Kneatrum/Irrigation_controller/documentation/Hardware/v2/PCB Files/IrrigationTimer.kicad_pcb

## KiCad design documentation/Hardware/v2/PCB Files/IrrigationTimer.kicad_pcb (2026-04-17)

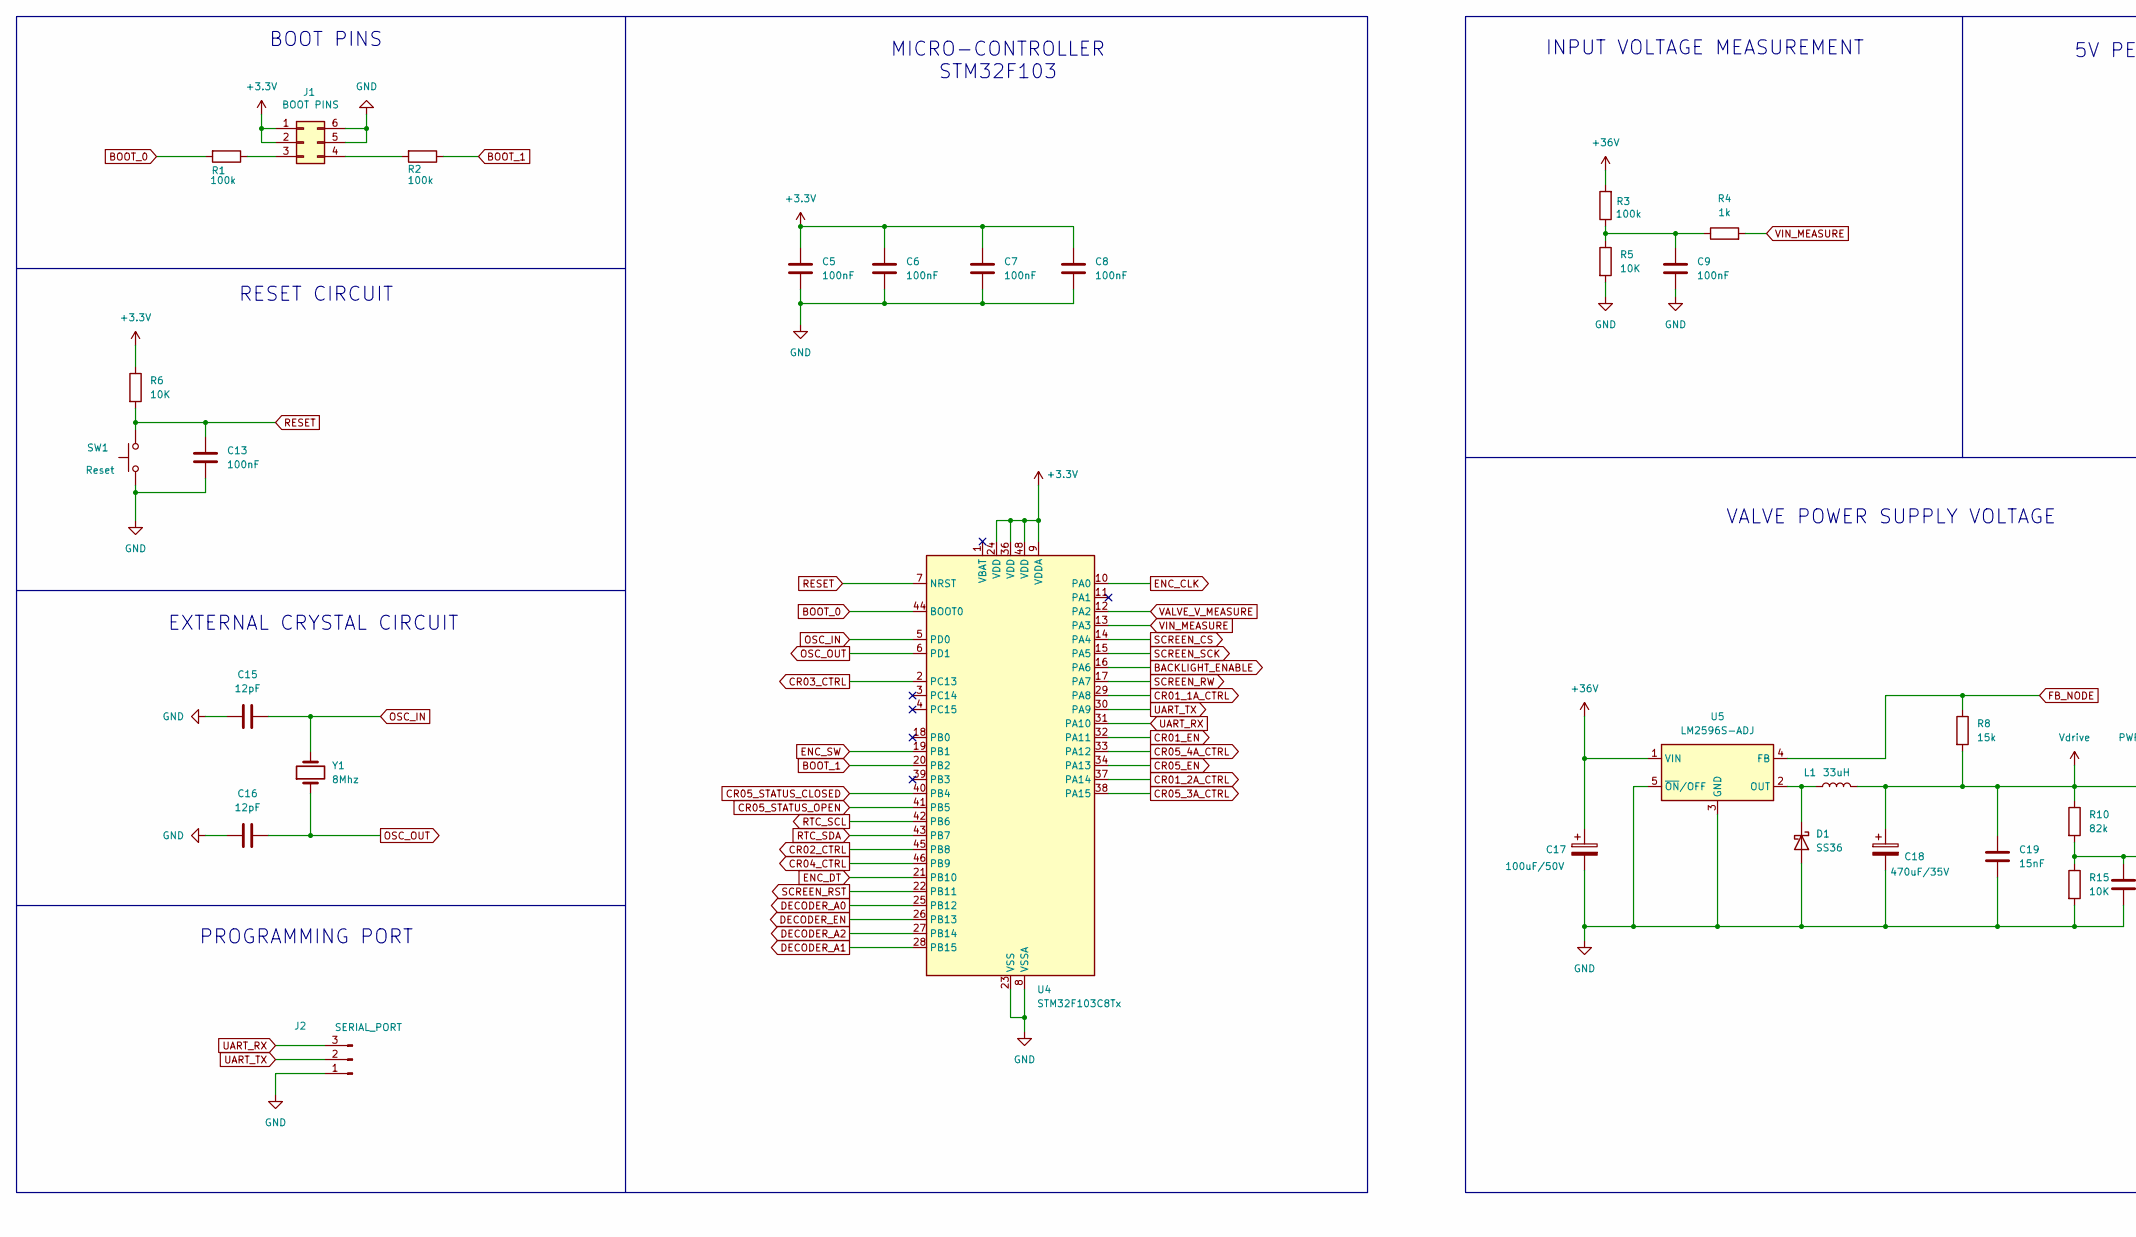
[picture p1: schematic IrrigationTimer.kicad_sch, part in row 1, column 1]

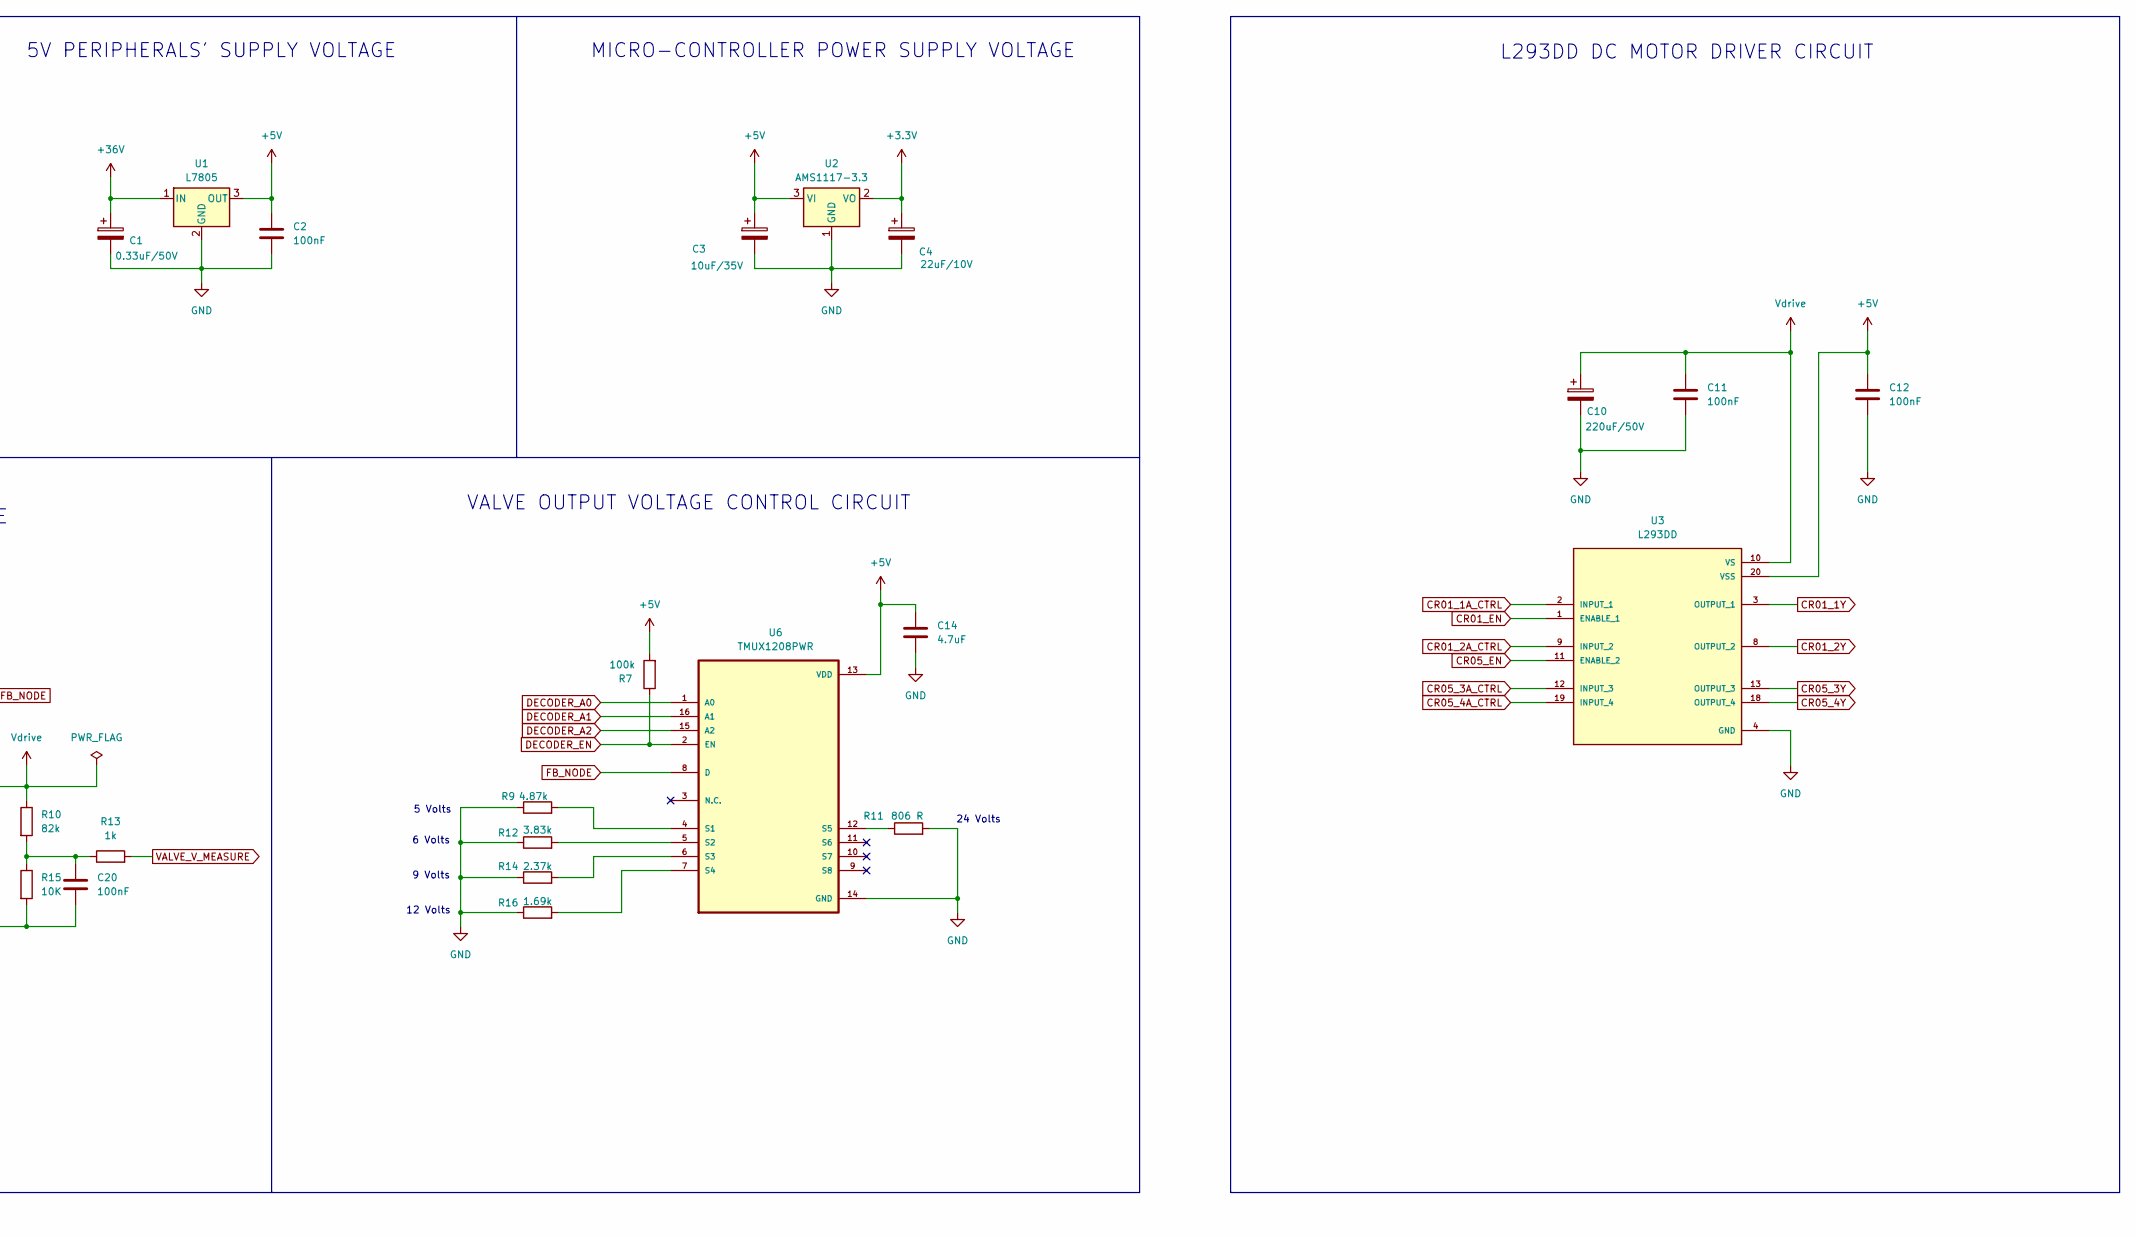
[picture p2: schematic IrrigationTimer.kicad_sch, part in row 1, column 2]

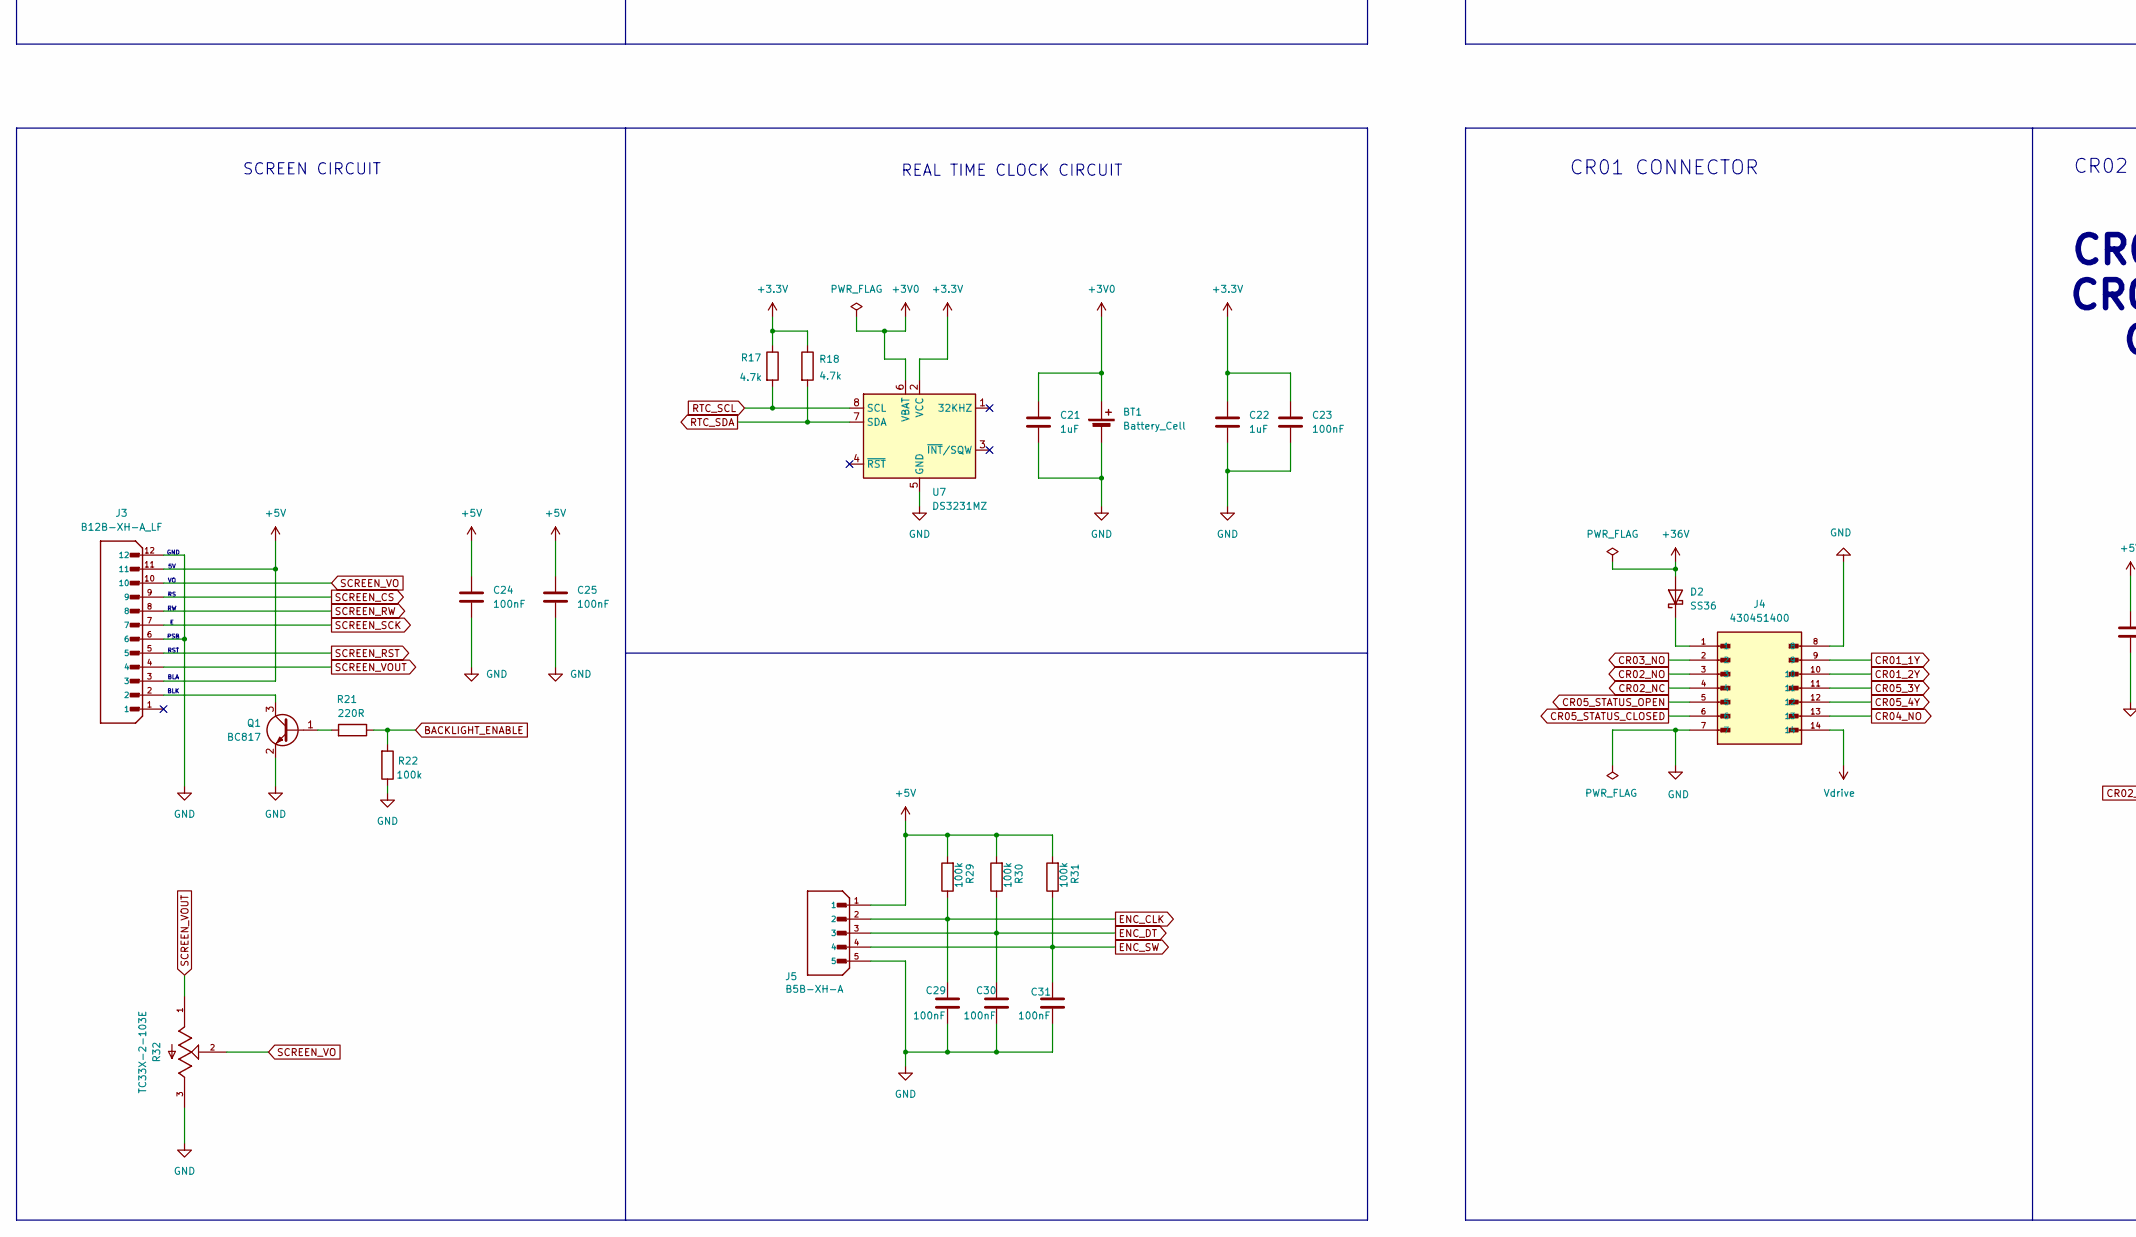
[picture p3: schematic IrrigationTimer.kicad_sch, part in row 2, column 1]

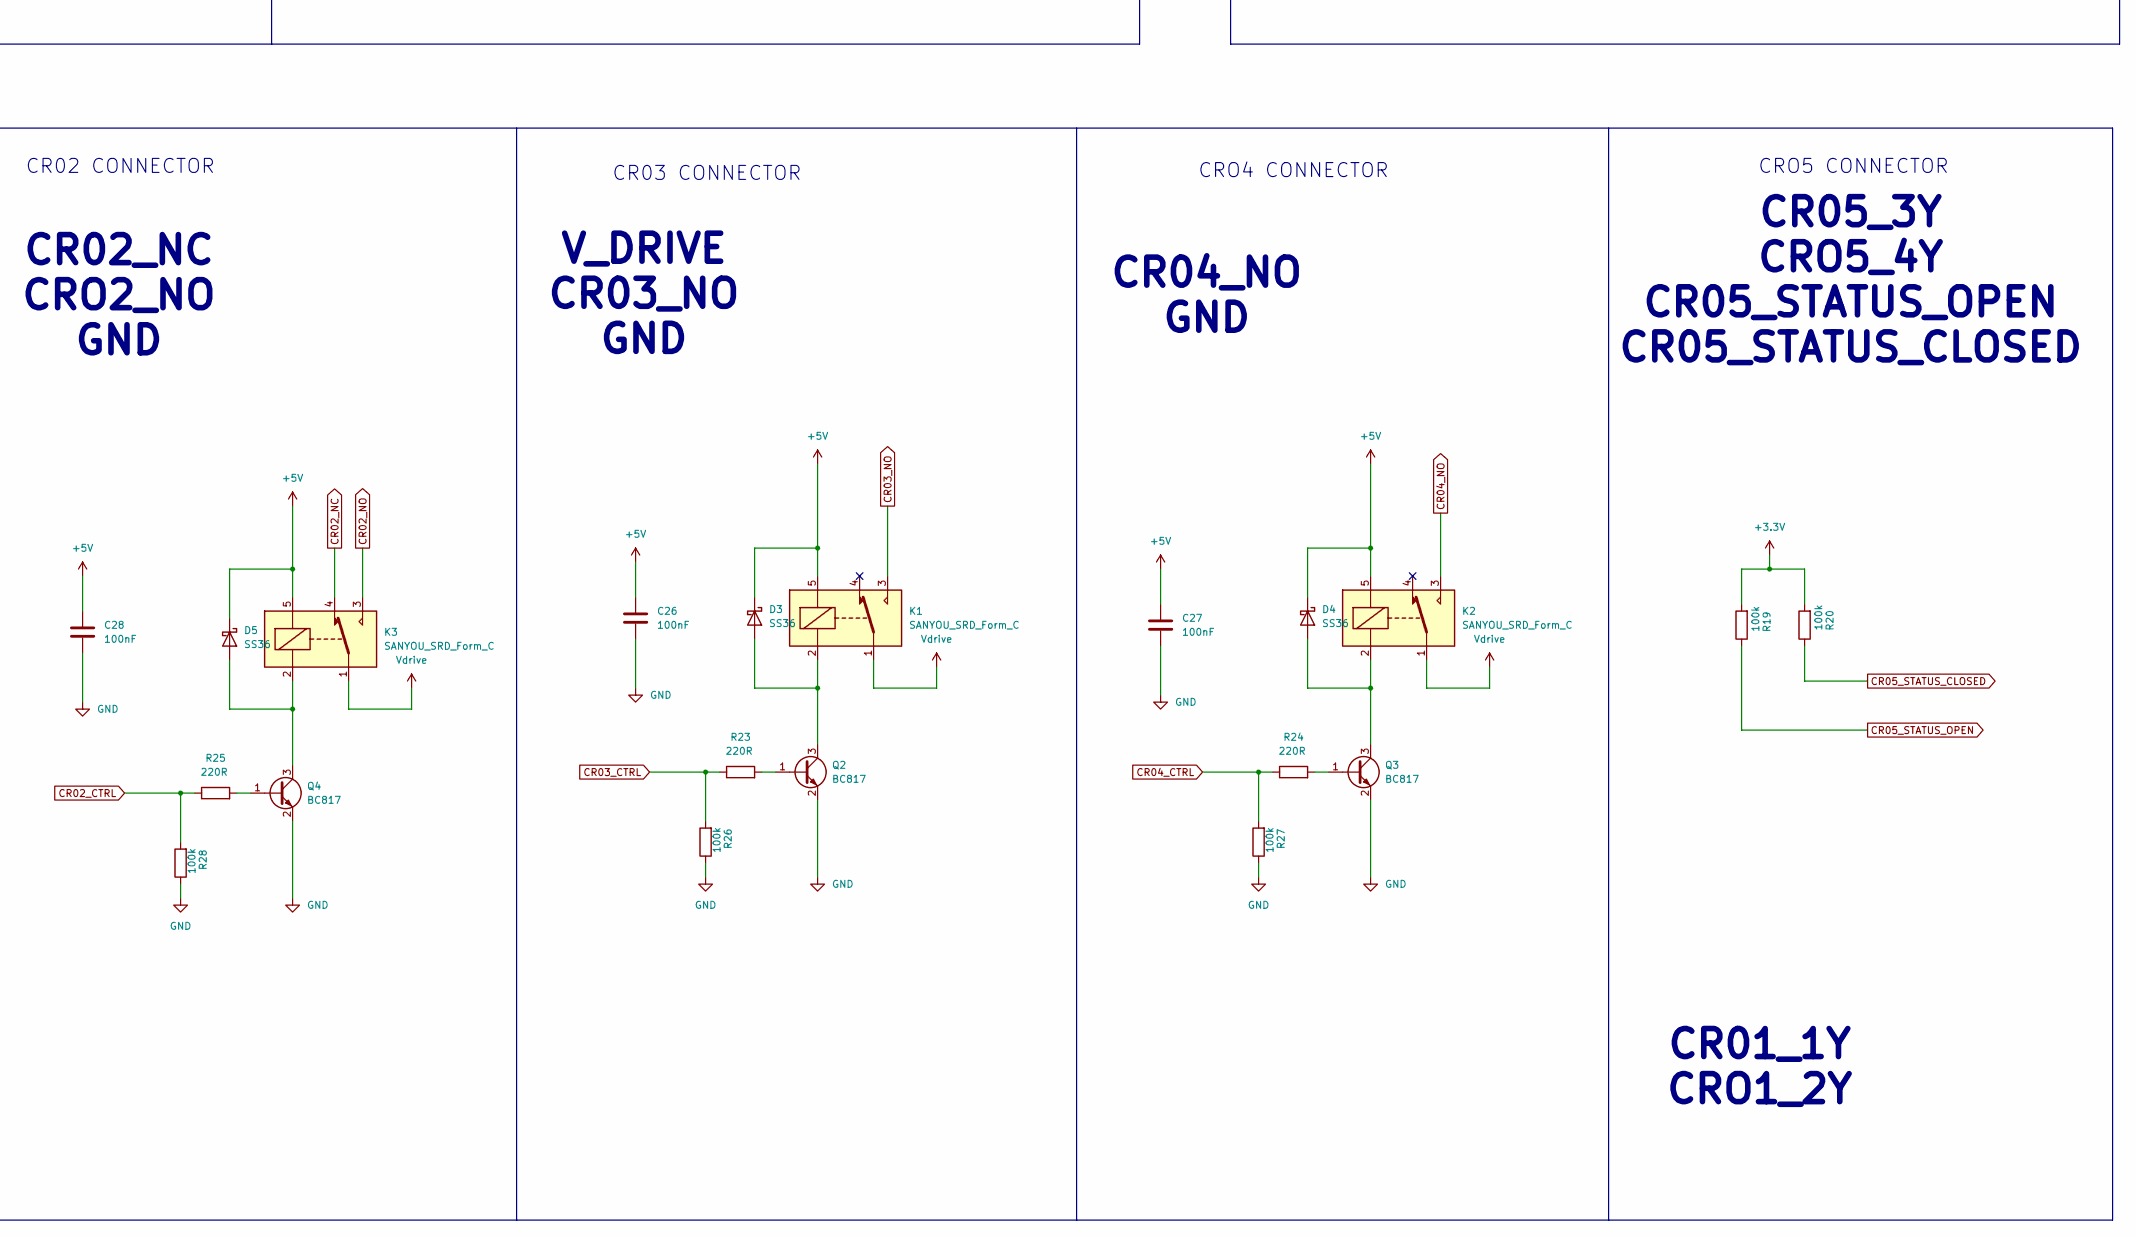
[picture p4: schematic IrrigationTimer.kicad_sch, part in row 2, column 2]

Parts:
BT1: Battery_Cell; BatteryHolder_MYOUNG_BS-07-A1BJ001_CR2032
C1: 0.33uF/50V; CP_Elec_4x5.4; LCSC PN C264238
C2, C5, C6, C7, C8, C9, C11, C12, C13, C20, C23, C24, C25, C26, C27, C28, C29, C30, C31: 100nF; C_0805_2012Metric; LCSC PN C1711
C3: 10uF/35V; CP_Elec_4x5.4; LCSC PN C4747970
C4: 22uF/10V; CP_Elec_4x5.4; LCSC PN C48970747
C10: 220uF/50V; CP_Elec_10x10.5; LCSC C970698
C14: 4.7uF; C_0805_2012Metric; LCSC PN C98192
C15, C16: 12pF; C_0805_2012Metric; LCSC PN C107108
C17: 100uF/50V; CP_Elec_8x10; LCSC PN C2836439
C18: 470uF/35V; CP_Elec_10x12.5; LCSC PN C22469994
C19: 15nF; C_0805_2012Metric; LCSC PN C445728
C21, C22: 1uF; C_0805_2012Metric; LCSC PN C28323
D1, D2, D3, D4, D5: SS36; D_SMA; LCSC PN C3014012
J1: BOOT PINS; PinHeader_2x03_P2.54mm_Vertical_SMD; LCSC PN C32713283
J2: SERIAL_PORT; PinHeader_1x03_P2.54mm_Vertical; LCSC PN C52016391
J3: B12B-XH-A_LF; JST_B12B-XH-A_LF__SN_; PARTREV 7/4/21; LCSC PN C52121892
J4: 430451400; MOLEX_430451400; PARTREV G; LCSC PN C22383229
J5: B5B-XH-A; JST_B5B-XH-A; PARTREV 7/4/21; LCSC PN C157991
K1, K2, K3: SANYOU_SRD_Form_C; Relay_SPDT_SANYOU_SRD_Series_Form_C; LCSC PN C35449
L1: 33uH; L_12x12mm_H8mm; LCSC PN C9400
Q1, Q2, Q3, Q4: BC817; SOT-23; LCSC PN C49238158
R1, R2, R3, R7, R19, R20, R22, R26, R27, R28, R29, R30, R31: 100k; R_0805_2012Metric; LCSC PN C2907293
R4, R13: 1k; R_0805_2012Metric; LCSC PN C2907232
R5, R6, R15: 10K; R_0805_2012Metric; LCSC PN C2907219
R8: 15k; R_0805_2012Metric; LCSC PN C2930170
R9: 4.87k; R_0805_2012Metric; LCSC PN C2930197
R10: 82k; R_0805_2012Metric; LCSC PN C17840
R11: 806 R; R_0805_2012Metric; LCSC PN C2999620
R12: 3.83k; R_0805_2012Metric; LCSC PN C2933428
R14: 2.37k; R_0805_2012Metric; LCSC PN C5126005
R16: 1.69k; R_0805_2012Metric; LCSC PN C2482737
R17, R18: 4.7k; R_0805_2012Metric; LCSC PN C2907326
R21, R23, R24, R25: 220R; R_0805_2012Metric; LCSC PN C17557
R32: TC33X-2-103E; TRIM_TC33X-2-103E; LCSC PN C719176
SW1: Reset; SW_Push_1P1T_XKB_TS-1187A; LCSC PN C318884
U1: L7805; TO-252-2; LCSC C42376985
U2: AMS1117-3.3; SOT-223-3_TabPin2; LCSC PN C5205141
U3: L293DD; SOIC127P1032X265-20N; LCSC PN C2973803
U4: STM32F103C8Tx; LQFP-48_7x7mm_P0.5mm; LCSC PN C8734
U5: LM2596S-ADJ; TO-263-5_TabPin3; LCSC PN C5276751
U6: TMUX1208PWR; SOP65P640X120-16N; LCSC PN C494728
U7: DS3231MZ; SOIC-8_3.9x4.9mm_P1.27mm; LCSC PN C107410
Y1: 8Mhz; Crystal_SMD_HC49-SD; LCSC PN C5265803

Connections:
+3.3V: C4.1, C5.1, C6.1, C7.1, C8.1, C22.1, C23.1, J1.1, J1.2, R6.1, R17.1, R18.1, R19.2, R20.2, U2.2 (VO), U4.9 (VDDA), U4.24 (VDD), U4.36 (VDD), U4.48 (VDD), U7.2 (VCC)
+3V0: BT1.1 (+), C21.1, U7.6 (VBAT)
+5V: C2.1, C3.1, C12.1, C14.1, C24.1, C25.1, C26.1, C27.1, C28.1, D3.1 (K), D4.1 (K), D5.1 (K), J3.3, J3.11, J5.1, K1.5, K2.5, K3.5, R7.2, R29.2, R30.2, R31.2, U1.3 (OUT), U2.3 (VI), U3.20 (VSS), U6.13 (VDD)
+36V: C1.1, C17.1, D2.2 (A), R3.2, U1.1 (IN), U5.1 (VIN)
BACKLIGHT_ENABLE: R21.1, R22.2, U4.16 (PA6)
BOOT_0: R1.2, U4.44 (BOOT0)
BOOT_1: R2.1, U4.20 (PB2)
CR01_1A_CTRL: U3.2 (INPUT_1), U4.29 (PA8)
CR01_1Y: J4.9, U3.3 (OUTPUT_1)
CR01_2A_CTRL: U3.9 (INPUT_2), U4.37 (PA14)
CR01_2Y: J4.10, U3.8 (OUTPUT_2)
CR01_EN: U3.1 (ENABLE_1), U4.32 (PA11)
CR02_CTRL: R25.1, R28.2, U4.45 (PB8)
CR02_NC: J4.4, K3.4
CR02_NO: J4.3, K3.3
CR03_CTRL: R23.1, R26.2, U4.2 (PC13)
CR03_NO: J4.2, K1.3
CR04_CTRL: R24.1, R27.2, U4.46 (PB9)
CR04_NO: J4.13, K2.3
CR05_3A_CTRL: U3.12 (INPUT_3), U4.38 (PA15)
CR05_3Y: J4.11, U3.13 (OUTPUT_3)
CR05_4A_CTRL: U3.19 (INPUT_4), U4.33 (PA12)
CR05_4Y: J4.12, U3.18 (OUTPUT_4)
CR05_EN: U3.11 (ENABLE_2), U4.34 (PA13)
CR05_STATUS_CLOSED: J4.6, R20.1, U4.40 (PB4)
CR05_STATUS_OPEN: J4.5, R19.1, U4.41 (PB5)
DECODER_A0: U4.25 (PB12), U6.1 (A0)
DECODER_A1: U4.28 (PB15), U6.16 (A1)
DECODER_A2: U4.27 (PB14), U6.15 (A2)
DECODER_EN: R7.1, U4.26 (PB13), U6.2 (EN)
ENC_CLK: C29.1, J5.2, R29.1, U4.10 (PA0)
ENC_DT: C30.1, J5.3, R30.1, U4.21 (PB10)
ENC_SW: C31.1, J5.4, R31.1, U4.19 (PB1)
FB_NODE: R8.1, U5.4 (FB), U6.8 (D)
GND: BT1.2 (-), C1.2, C2.2, C3.2, C4.2, C5.2, C6.2, C7.2, C8.2, C9.2, C10.2, C11.2, C12.2, C13.2, C14.2, C15.1, C16.1, C17.2, C18.2, C19.2, C20.2, C21.2, C22.2, C23.2, C24.2, C25.2, C26.2, C27.2, C28.2, C29.2, C30.2, C31.2, D1.2 (A), J1.5, J1.6, J2.1, J3.6, J3.12, J4.7, J4.8, J5.5, Q1.2 (E), Q2.2 (E), Q3.2 (E), Q4.2 (E), R5.2, R9.1, R11.2, R12.1, R14.1, R15.2, R16.1, R22.1, R26.1, R27.1, R28.1, R32.3, SW1.1, U1.2 (GND), U2.1 (GND), U3.4 (GND), U3.5 (GND), U3.6 (GND), U3.7 (GND), U3.14 (GND), U3.15 (GND), U3.16 (GND), U3.17 (GND), U4.8 (VSSA), U4.23 (VSS), U4.35 (VSS), U4.47 (VSS), U5.3 (GND), U5.5 (~ON/OFF), U6.14 (GND), U7.5 (GND)
unnamed: C9.1, R3.1, R4.1, R5.1
unnamed: C20.1, R10.2, R13.1, R15.1
unnamed: D1.1 (K), L1.1, U5.2 (OUT)
unnamed: D2.1 (K), J4.1
unnamed: D3.2 (A), K1.2, Q2.3 (C)
unnamed: D4.2 (A), K2.2, Q3.3 (C)
unnamed: D5.2 (A), K3.2, Q4.3 (C)
unnamed: J1.3, R1.1
unnamed: J1.4, R2.2
unnamed: Q1.1 (B), R21.2
unnamed: J3.2, Q1.3 (C)
unnamed: Q2.1 (B), R23.2
unnamed: Q3.1 (B), R24.2
unnamed: Q4.1 (B), R25.2
unnamed: R9.2, U6.4 (S1)
unnamed: R12.2, U6.5 (S2)
unnamed: R14.2, U6.6 (S3)
unnamed: R16.2, U6.7 (S4)
unnamed: R11.1, U6.12 (S5)
OSC_IN: C15.2, U4.5 (PD0), Y1.2
OSC_OUT: C16.2, U4.6 (PD1), Y1.1
RESET: C13.1, R6.2, SW1.2, U4.7 (NRST)
RTC_SCL: R17.2, U4.42 (PB6), U7.8 (SCL)
RTC_SDA: R18.2, U4.43 (PB7), U7.7 (SDA)
SCREEN_CS: J3.9, U4.14 (PA4)
SCREEN_RST: J3.5, U4.22 (PB11)
SCREEN_RW: J3.8, U4.17 (PA7)
SCREEN_SCK: J3.7, U4.15 (PA5)
SCREEN_VO: J3.10, R32.2
SCREEN_VOUT: J3.4, R32.1
UART_RX: J2.3, U4.31 (PA10)
UART_TX: J2.2, U4.30 (PA9)
VALVE_V_MEASURE: R13.2, U4.12 (PA2)
VIN_MEASURE: R4.2, U4.13 (PA3)
Vdrive: C10.1, C11.1, C18.1, C19.1, J4.14, K1.1, K2.1, K3.1, L1.2, R8.2, R10.1, U3.10 (VS)

Notes on the sheet:
INPUT VOLTAGE MEASUREMENT
L293DD DC MOTOR DRIVER CIRCUIT
RST
12 Volts
CR01_1Y CRO1_2Y
VALVE OUTPUT VOLTAGE CONTROL CIRCUIT
6 Volts
CR05_3Y CRO5_4Y CR05_STATUS_OPEN CR05_STATUS_CLOSED
MICRO-CONTROLLER STM32F103
CRO5 CONNECTOR
REAL TIME CLOCK CIRCUIT
CR04_NO GND
SCREEN CIRCUIT
BOOT PINS
5 Volts
BLK
CR02 CONNECTOR
CR01 CONNECTOR
VALVE POWER SUPPLY VOLTAGE
9 Volts
GND
CR02_NC CRO2_NO GND
MICRO-CONTROLLER POWER SUPPLY VOLTAGE
24 Volts
BLA
V_DRIVE CR03_NO GND
5V PERIPHERALS' SUPPLY VOLTAGE
CR03 CONNECTOR
RESET CIRCUIT
PROGRAMMING PORT
CRO4 CONNECTOR
EXTERNAL CRYSTAL CIRCUIT
PSB

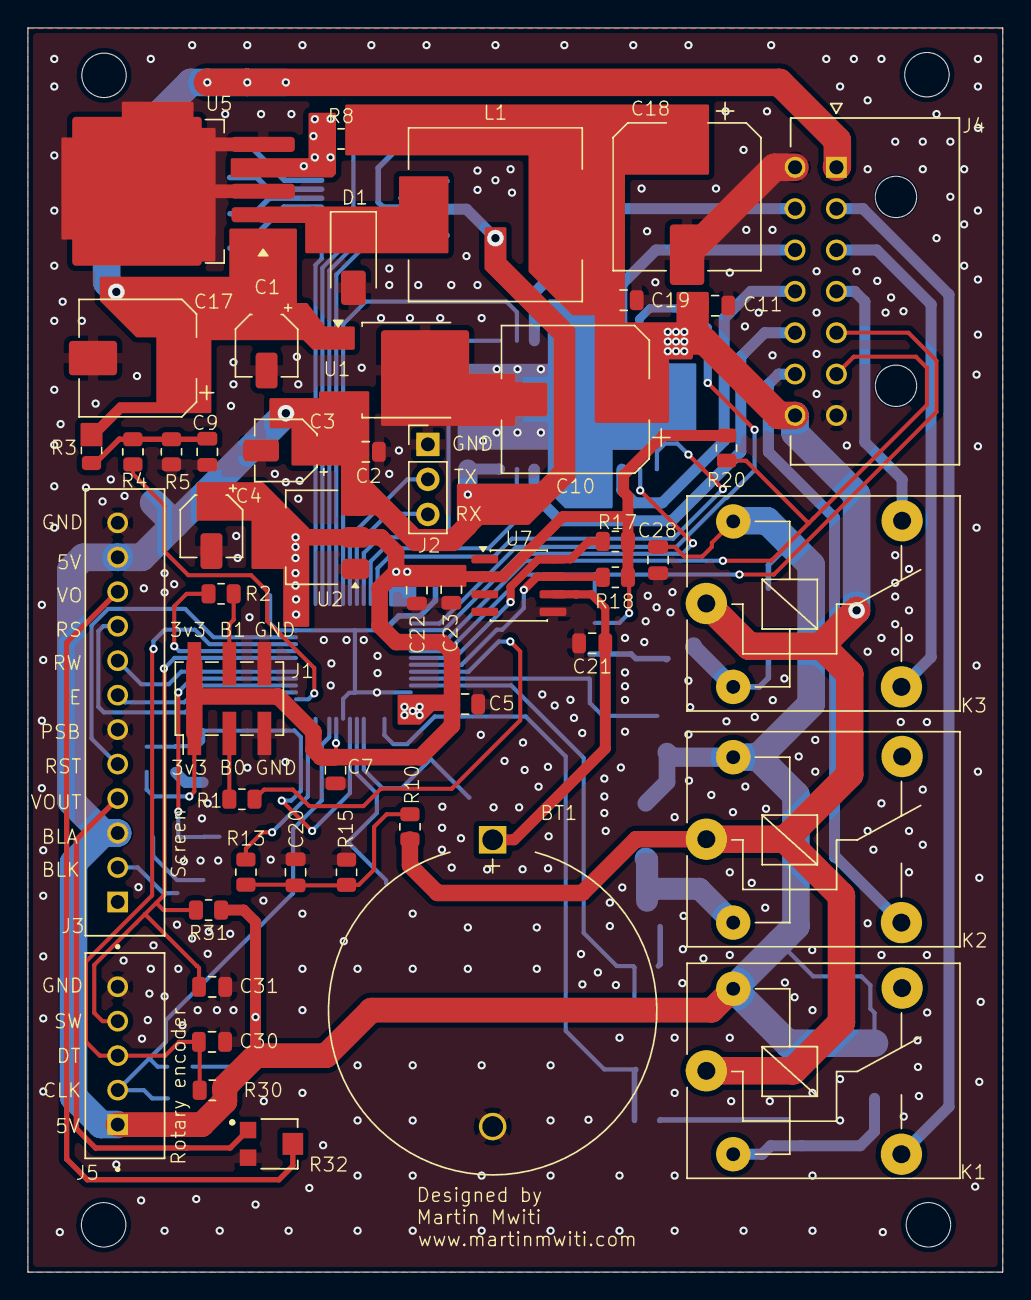
[picture p5: board IrrigationTimer.kicad_pcb from above]

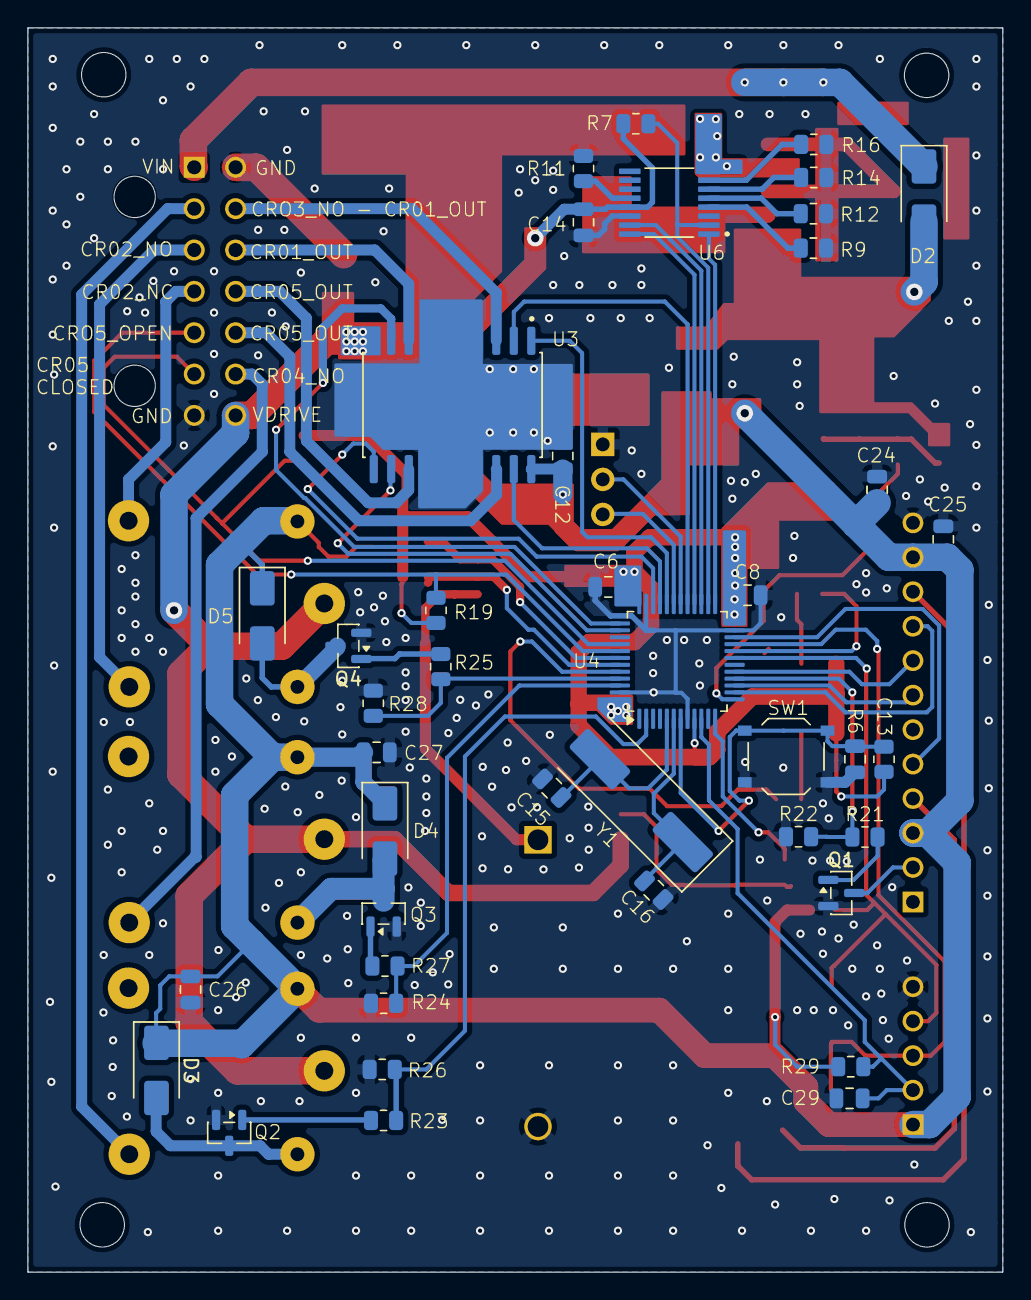
[picture p6: board IrrigationTimer.kicad_pcb from below]

Board: 2 copper layers, 70.7 x 90.2 mm, 91 parts (42 on the bottom side), 70 nets.
