Kneatrum/Irrigation_controller/(commit log)

2025-11-15 Improve button press functionality and add a long press detection
2025-11-15 Detach encoder DT pin from interrupt
2025-11-16 Add state related variables into stateMachine and handle resetting in functions
    [main.cpp, states.cpp, states.h]
2025-11-16 Handle resetting of states
    [states.cpp]
2025-11-16 Implement logic for skipping "Force Stop" when valve is closed
    [main.cpp]
2025-11-16 Reset timers when button is pressed
    [main.cpp]
2025-11-16 Prevent time updates when setting time
    [main.cpp]
2025-11-16 Remove print statement
2025-11-16 Add force_stop and valve_on into stateMachine struct
2025-11-16 Add force_stop and valve_on to stateMachine struct
2025-11-16 Add a function for printing the state machine struct
2025-11-16 Update valve_on state after turning it on or off
2025-11-17 Remove print statements
2026-04-17 Add PCB files for Irrigation Timer v2 and LCSC order details
    - Created IrrigationTimer2.csv with component references, values, and quantities.
    - Added LCSC_ORDER.csv containing part numbers, manufacturer details, and pricing information for components used in the PCB design.
    [IrrigationTimer.kicad_pcb, IrrigationTimer.kicad_sch, IrrigationTimer2.csv, LCSC_ORDER.csv]
2026-04-17 Change from Arduino Micro to STM32f103
2026-05-21 - Change from arduino micro to stm32f103. - Enable user to choose from 5 voltages. - Enable user to choose from 5 types of valves. - Enable user to set up to 4 schedules. - Add menu items into a link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
2026-08-30 Add a note to change to a non-SPI pin
2026-08-30 Refactor the procedure for setting voltage and add more notifications
